iley/nixie-clock/README.md

Yet another nixie clock
=======================

This repo contains hardware design files and firmware source code for a nixie tube clock.

The clock uses soviet IN-12 tubes and K155ID1 driver ICs.

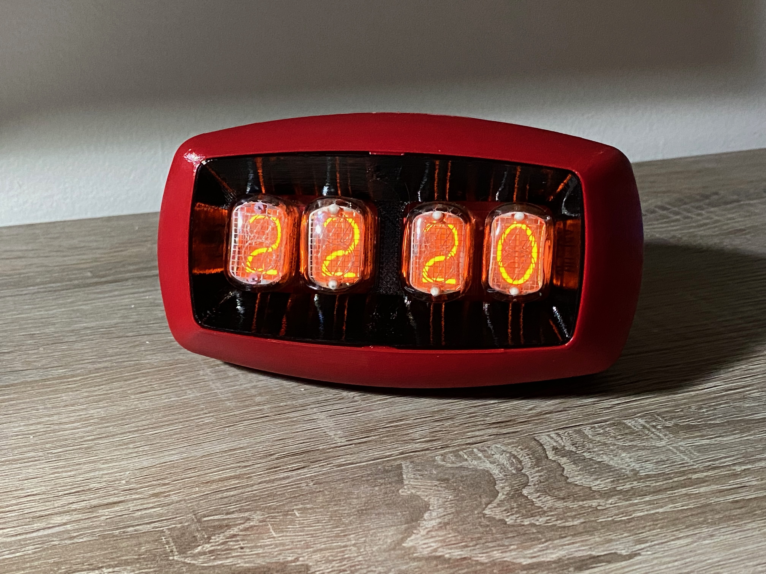
[picture p1: media/nixie_clock_v3.jpeg]
photo of the clock
