iley/nixie-clock/media/nixie_clock_01.jpg

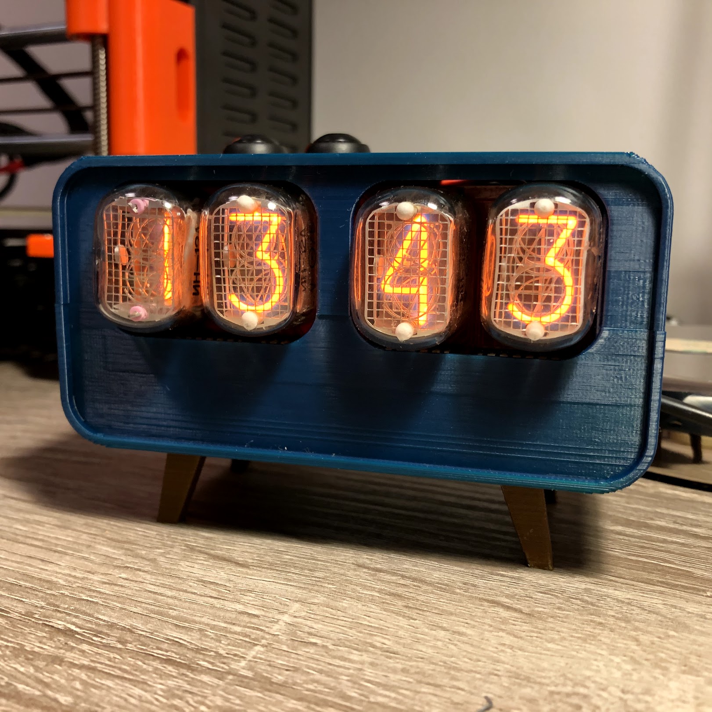
media/nixie_clock_01.jpg
