iley/nixie-clock/pcb/front/nixie_clock_front.step

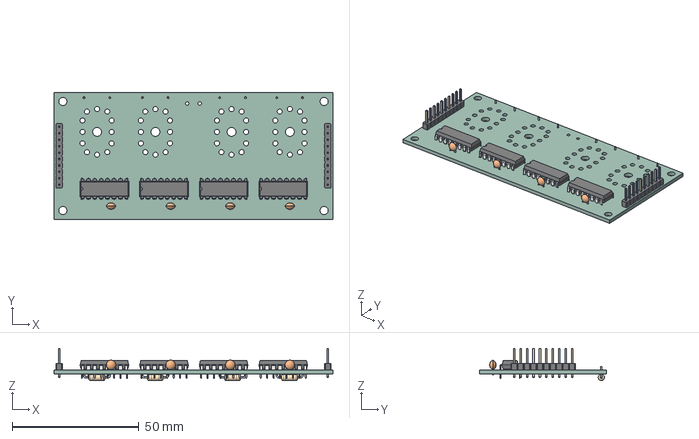
[picture p3: CAD file, 2023-06-15]
pcb/front/nixie_clock_front.step
110.0 x 50.0 x 12.7 mm
_autosave-nixie_clock_front PCB
