iley/nixie-clock/shell/v3/insert.stl

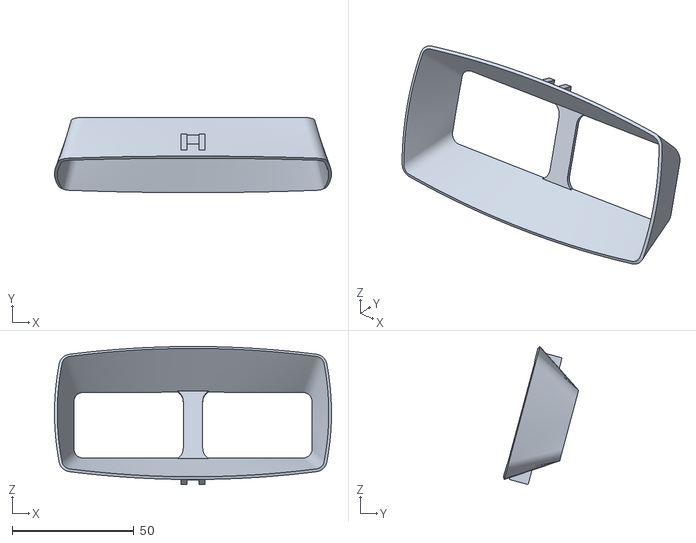
[picture p4: CAD file, 2023-06-15]
shell/v3/insert.stl
113.7 x 30.9 x 56.7
