iley/nixie-clock/shell/v3/front.stl

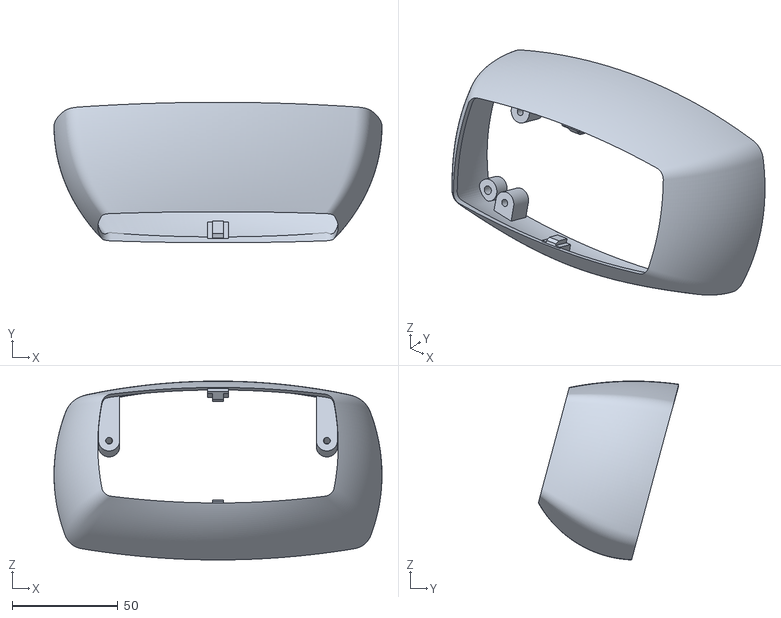
[picture p5: CAD file, 2023-06-15]
shell/v3/front.stl
155.1 x 66.4 x 84.6
