iley/nixie-clock/shell/v3/back.stl

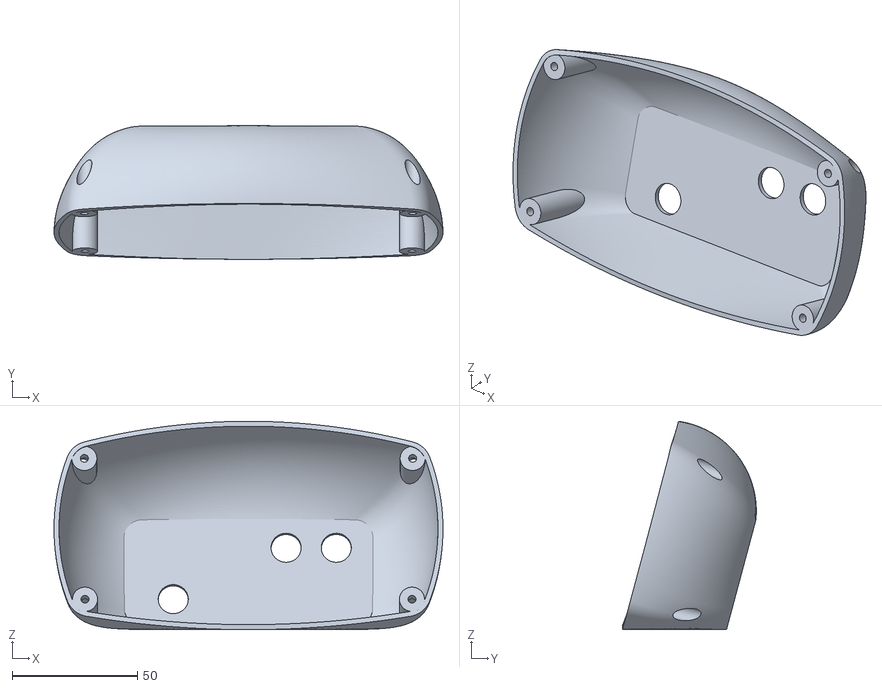
[picture p6: CAD file, 2023-06-15]
shell/v3/back.stl
155.1 x 53.3 x 83.1
