iley/nixie-clock/shell/v1/nixie_clock_case_upper.stl

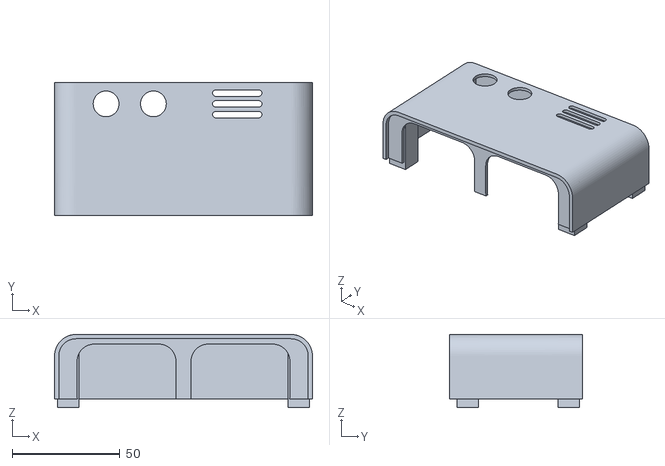
[picture p7: CAD file, 2019-11-12, an earlier design]
shell/v1/nixie_clock_case_upper.stl
120.0 x 62.0 x 34.0
