iley/nixie-clock/shell/v2/stand.stl

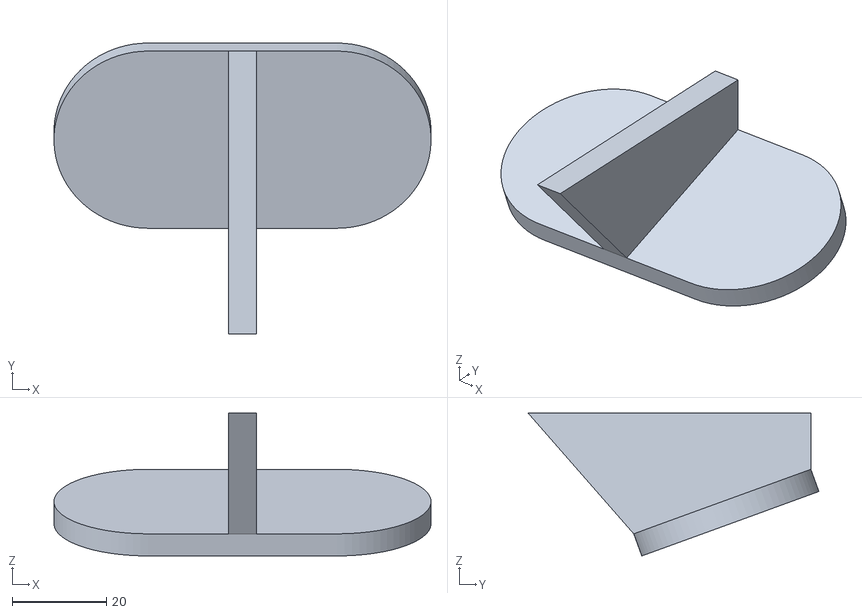
[picture p8: CAD file, 2020-01-18, an earlier design]
shell/v2/stand.stl
80.0 x 61.7 x 30.3
