iley/nixie-clock/shell/v1/nixie_clock_case_lower.stl

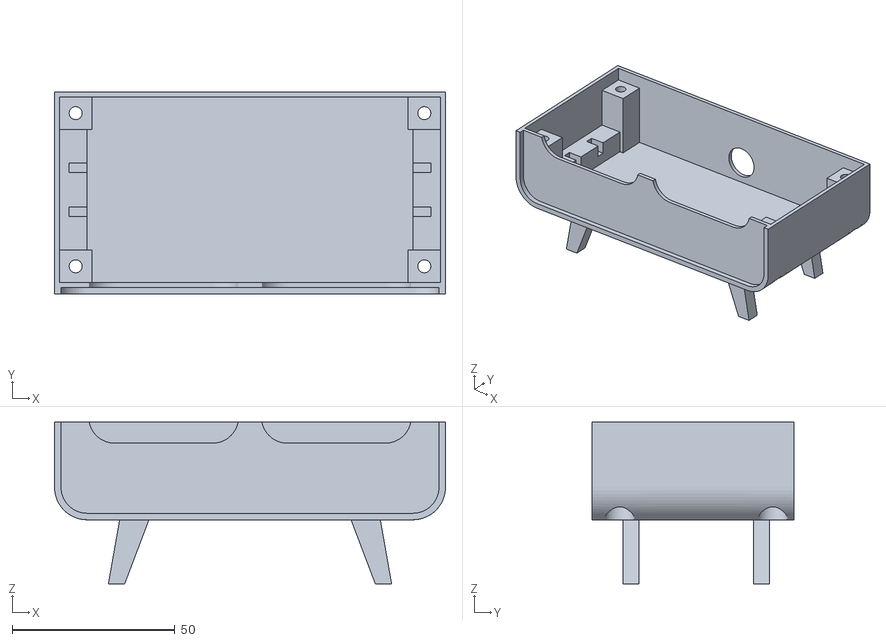
[picture p9: CAD file, 2019-11-12, an earlier design]
shell/v1/nixie_clock_case_lower.stl
120.0 x 62.0 x 49.7
