iley/nixie-clock/shell/v2/lower.stl

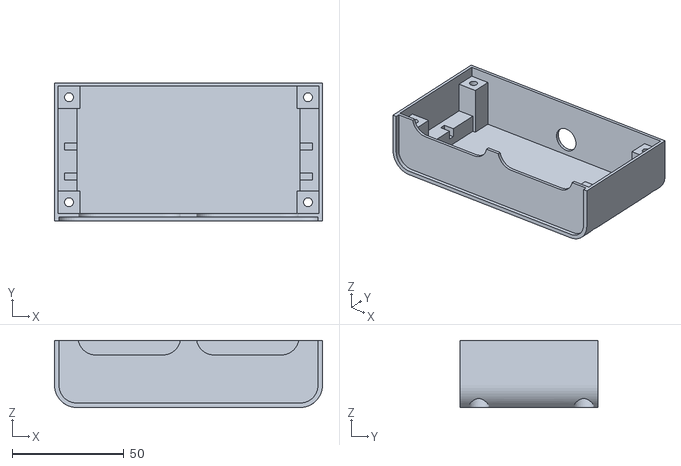
[picture p10: CAD file, 2020-01-18, an earlier design]
shell/v2/lower.stl
120.0 x 62.0 x 30.0
