iley/nixie-clock/(list of files, cad)

Other CAD files:
shell/v2/upper.stl
shell/v1/nixie_clock_case.f3d
shell/v2/shell_v2.f3d
