iley/nixie-clock/pcb/back/schematic.pdf

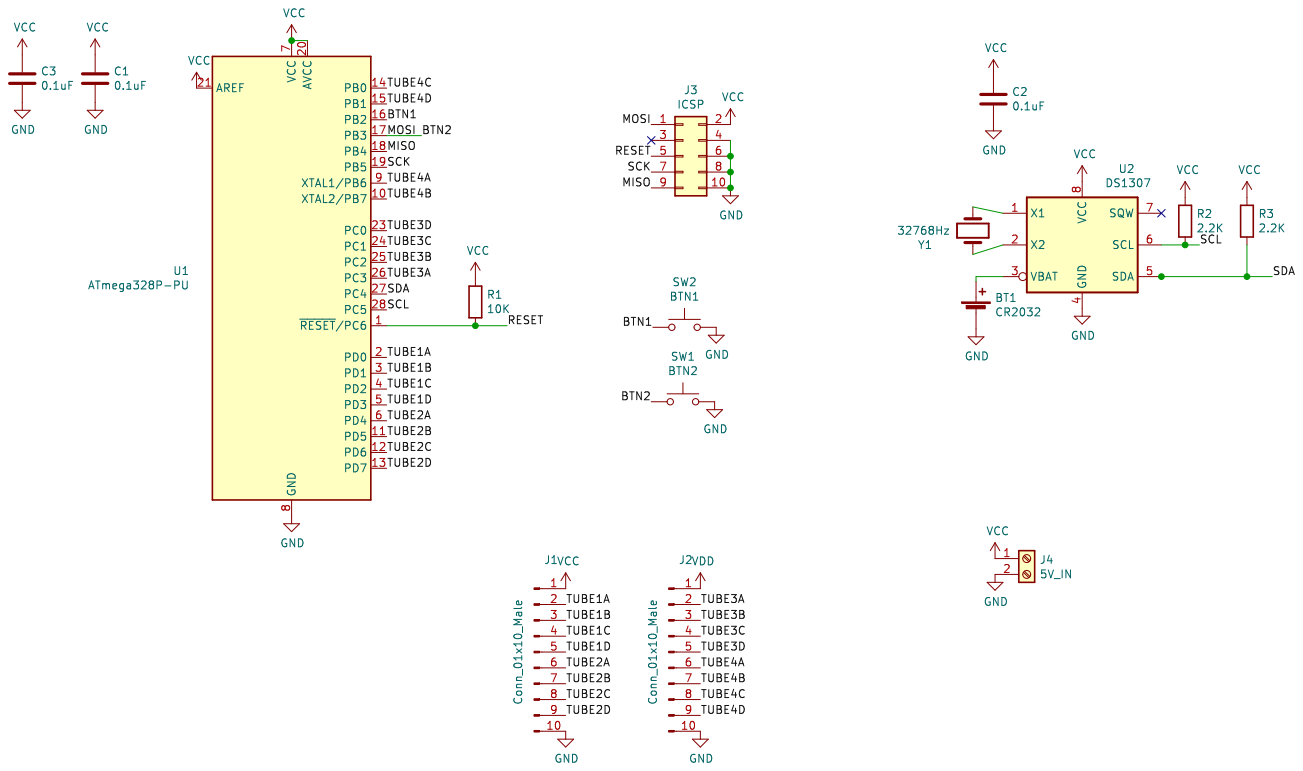
[picture p11: page 1]
