iley/nixie-clock/pcb/back_v3/nixie_back_v3.kicad_pcb

## KiCad design pcb/back_v3/nixie_back_v3.kicad_pcb (2023-06-10)

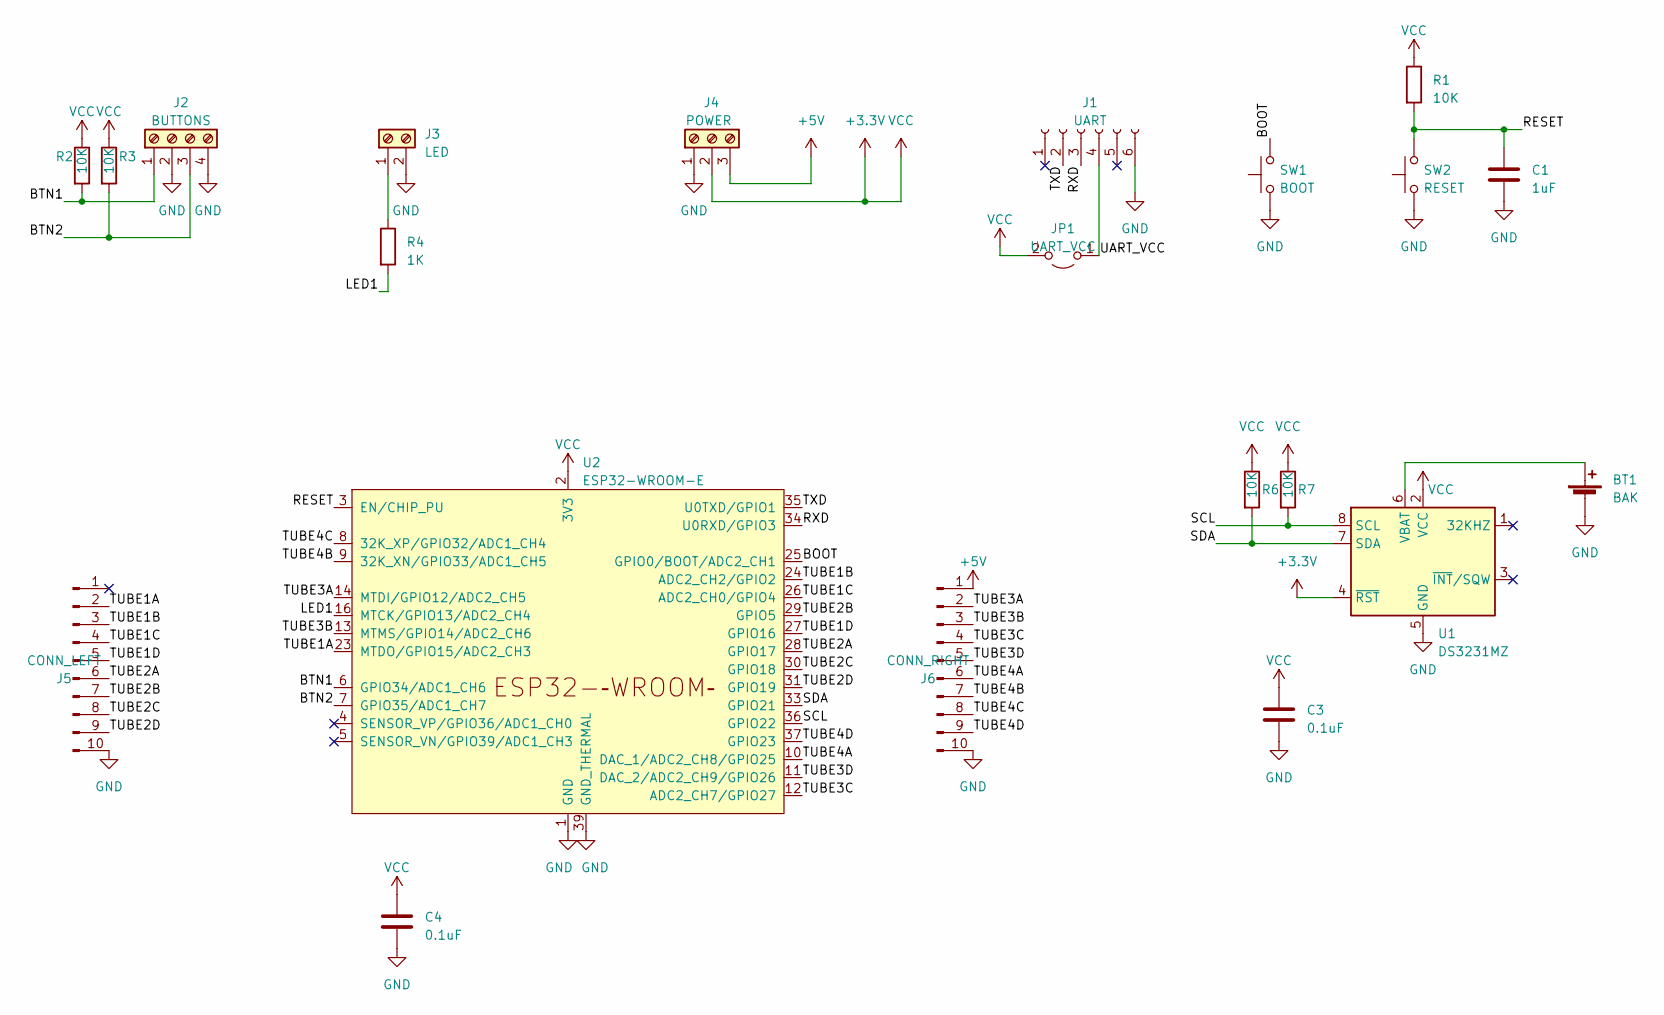
[picture p12: schematic nixie_back_v3.kicad_sch, Nixie Clock Back Panel]

Parts:
BT1: BAK; BatteryHolder_Keystone_103_1x20mm
C1: 1uF; C_1206_3216Metric_Pad1.33x1.80mm_HandSolder
C3, C4: 0.1uF; C_1206_3216Metric_Pad1.33x1.80mm_HandSolder
J1: UART; PinHeader_1x06_P2.54mm_Vertical
J2: BUTTONS; TerminalBlock_Altech_AK300-4_P5.00mm
J3: LED; TerminalBlock_Altech_AK300-2_P5.00mm
J4: POWER; TerminalBlock_Altech_AK300-3_P5.00mm
J5: CONN_LEFT; PinSocket_1x10_P2.54mm_Vertical
J6: CONN_RIGHT; PinSocket_1x10_P2.54mm_Vertical
JP1: UART_VCC; PinHeader_1x02_P2.54mm_Vertical
R1, R2, R3, R6, R7: 10K; R_1206_3216Metric_Pad1.30x1.75mm_HandSolder
R4: 1K; R_1206_3216Metric_Pad1.30x1.75mm_HandSolder
SW1: BOOT; SW_Push_1P1T_XKB_TS-1187A
SW2: RESET; SW_Push_1P1T_XKB_TS-1187A
U1: DS3231MZ; SOIC-8_3.9x4.9mm_P1.27mm
U2: ESP32-WROOM-E; ESP32-WROOM-32E

Connections:
+3.3V: C3.1, C4.1, J4.2, JP1.2 (B), R1.1, R2.1, R3.1, R6.1, R7.1, U1.2 (VCC), U1.4 (~RST), U2.2 (3V3)
+5V: J4.3, J6.1
/BOOT: SW1.2, U2.25 (GPIO0/BOOT/ADC2_CH1)
/BTN1: J2.1, R2.2, U2.6 (GPIO34/ADC1_CH6)
/BTN2: J2.3, R3.2, U2.7 (GPIO35/ADC1_CH7)
/LED1: R4.2, U2.16 (MTCK/GPIO13/ADC2_CH4)
/RESET: C1.1, R1.2, SW2.2, U2.3 (EN/CHIP_PU)
/RXD: J1.3, U2.34 (U0RXD/GPIO3)
/SCL: R7.2, U1.8 (SCL), U2.36 (GPIO22)
/SDA: R6.2, U1.7 (SDA), U2.33 (GPIO21)
/TUBE1A: J5.2, U2.23 (MTDO/GPIO15/ADC2_CH3)
/TUBE1B: J5.3, U2.24 (ADC2_CH2/GPIO2)
/TUBE1C: J5.4, U2.26 (ADC2_CH0/GPIO4)
/TUBE1D: J5.5, U2.27 (GPIO16)
/TUBE2A: J5.6, U2.28 (GPIO17)
/TUBE2B: J5.7, U2.29 (GPIO5)
/TUBE2C: J5.8, U2.30 (GPIO18)
/TUBE2D: J5.9, U2.31 (GPIO19)
/TUBE3A: J6.2, U2.14 (MTDI/GPIO12/ADC2_CH5)
/TUBE3B: J6.3, U2.13 (MTMS/GPIO14/ADC2_CH6)
/TUBE3C: J6.4, U2.12 (ADC2_CH7/GPIO27)
/TUBE3D: J6.5, U2.11 (DAC_2/ADC2_CH9/GPIO26)
/TUBE4A: J6.6, U2.10 (DAC_1/ADC2_CH8/GPIO25)
/TUBE4B: J6.7, U2.9 (32K_XN/GPIO33/ADC1_CH5)
/TUBE4C: J6.8, U2.8 (32K_XP/GPIO32/ADC1_CH4)
/TUBE4D: J6.9, U2.37 (GPIO23)
/TXD: J1.2, U2.35 (U0TXD/GPIO1)
/UART_VCC: J1.4, JP1.1 (A)
GND: BT1.2 (-), C1.2, C3.2, C4.2, J1.6, J2.2, J2.4, J3.2, J4.1, J5.10, J6.10, SW1.1, SW2.1, U1.5 (GND), U2.1 (GND), U2.15 (GND), U2.38 (GND), U2.39 (GND_THERMAL)
unnamed: BT1.1 (+), U1.6 (VBAT)
unnamed: J3.1, R4.1

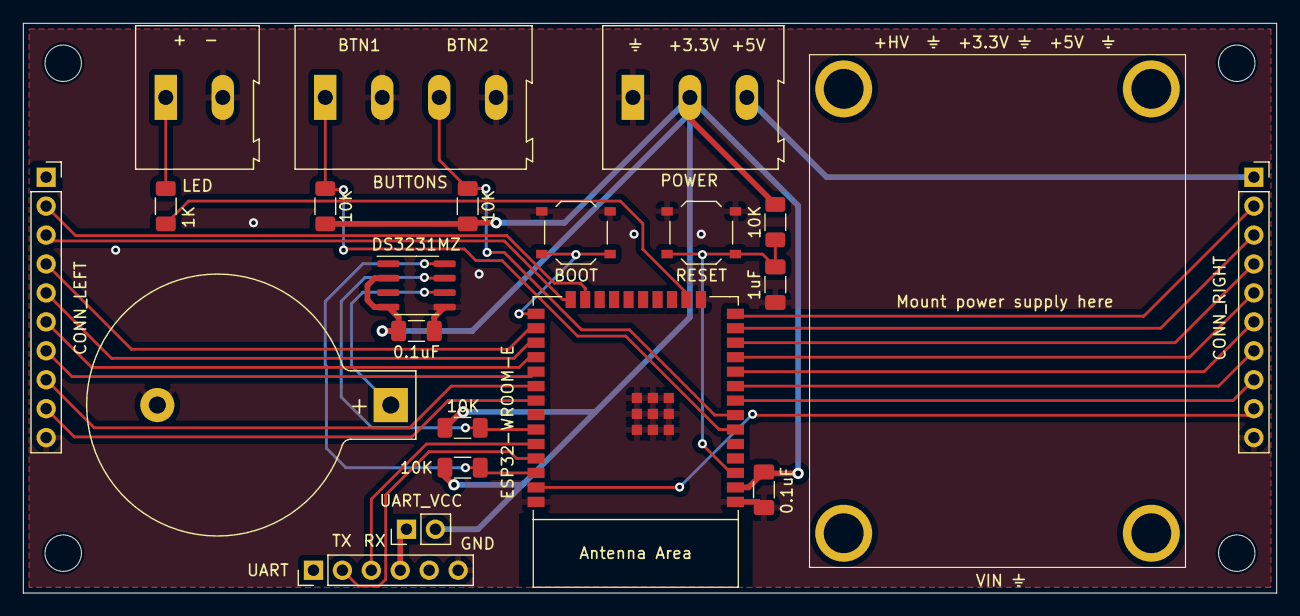
[picture p13: board nixie_back_v3.kicad_pcb from above]

Board: 2 copper layers, 110.0 x 50.0 mm, 21 parts (0 on the bottom side), 31 nets.
