iley/nixie-clock/pcb/back/nixie_clock_back.kicad_pcb

## KiCad design pcb/back/nixie_clock_back.kicad_pcb (2023-02-11, an earlier design)

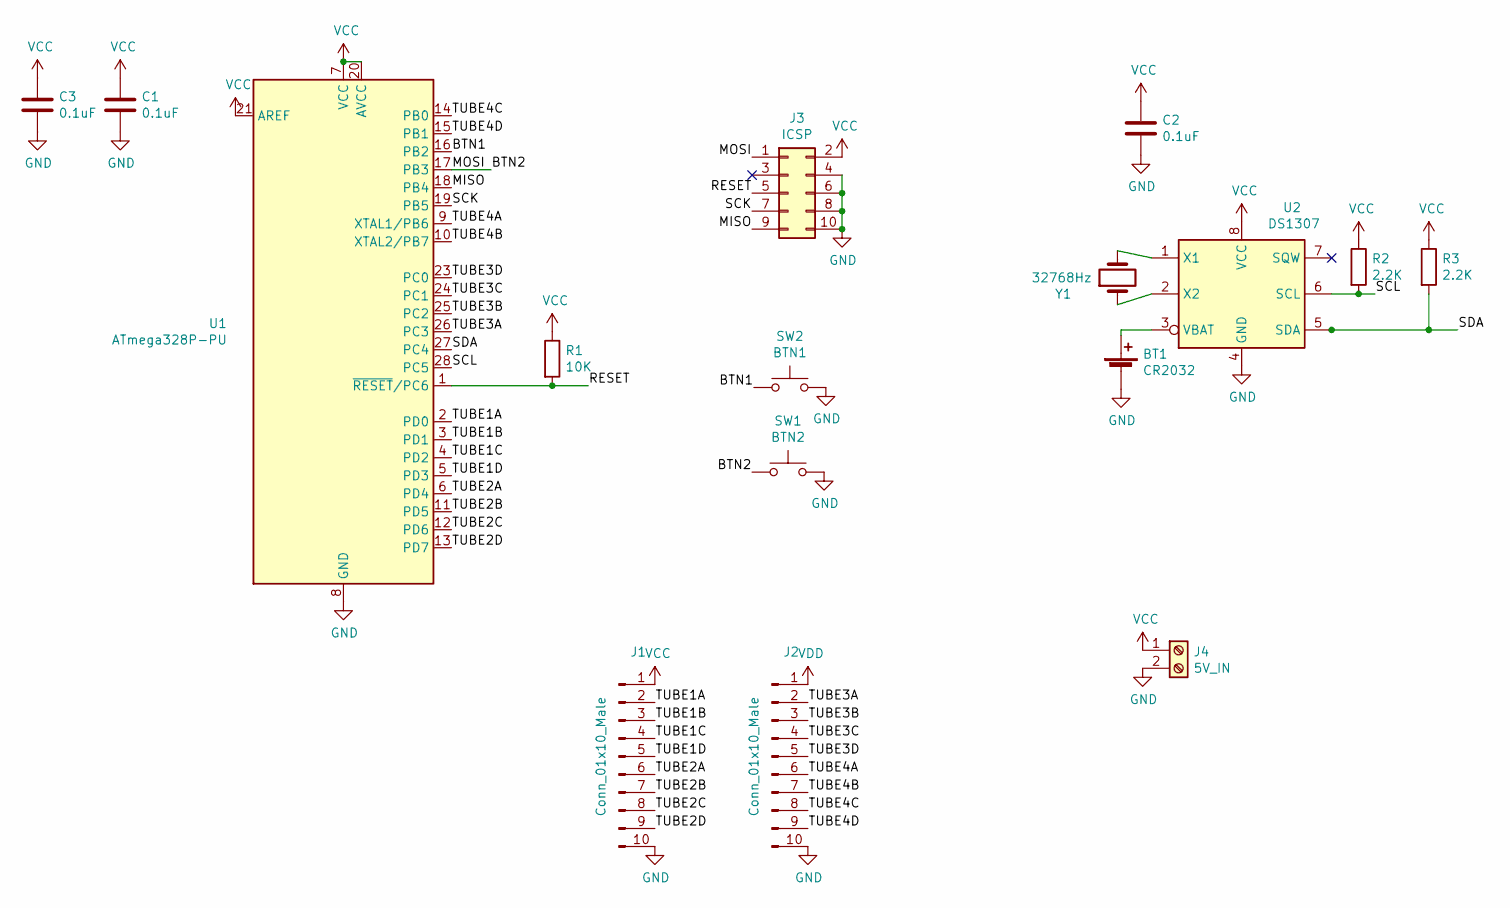
[picture p14: schematic nixie_clock_back.kicad_sch]

Parts:
BT1: CR2032; BatteryHolder_Keystone_103_1x20mm
C1, C2, C3: 0.1uF; C_Disc_D3.8mm_W2.6mm_P2.50mm
J1, J2: Conn_01x10_Male; PinSocket_1x10_P2.54mm_Vertical
J3: ICSP; Atmel_ISP_Socket_10pin
J4: 5V_IN; Terminal_Block_KF301-5.0-2P
R1: 10K; R_Axial_DIN0207_L6.3mm_D2.5mm_P10.16mm_Horizontal
R2, R3: 2.2K; R_Axial_DIN0207_L6.3mm_D2.5mm_P10.16mm_Horizontal
SW1: BTN2; JST_XH_B2B-XH-A_1x02_P2.50mm_Vertical
SW2: BTN1; JST_XH_B2B-XH-A_1x02_P2.50mm_Vertical
U1: ATmega328P-PU; DIP-28_W7.62mm
U2: DS1307; DIP-8_W7.62mm
Y1: 32768Hz; Crystal_C38-LF_D3.0mm_L8.0mm_Horizontal

Connections:
/BTN1: SW2.1, U1.16 (PB2)
/BTN2: J3.1, SW1.1, U1.17 (PB3)
/MISO: J3.9, U1.18 (PB4)
/RESET: J3.5, R1.2, U1.1 (~RESET/PC6)
/SCK: J3.7, U1.19 (PB5)
/SCL: R2.2, U1.28 (PC5), U2.6 (SCL)
/SDA: R3.2, U1.27 (PC4), U2.5 (SDA)
/TUBE1A: J1.2, U1.2 (PD0)
/TUBE1B: J1.3, U1.3 (PD1)
/TUBE1C: J1.4, U1.4 (PD2)
/TUBE1D: J1.5, U1.5 (PD3)
/TUBE2A: J1.6, U1.6 (PD4)
/TUBE2B: J1.7, U1.11 (PD5)
/TUBE2C: J1.8, U1.12 (PD6)
/TUBE2D: J1.9, U1.13 (PD7)
/TUBE3A: J2.2, U1.26 (PC3)
/TUBE3B: J2.3, U1.25 (PC2)
/TUBE3C: J2.4, U1.24 (PC1)
/TUBE3D: J2.5, U1.23 (PC0)
/TUBE4A: J2.6, U1.9 (XTAL1/PB6)
/TUBE4B: J2.7, U1.10 (XTAL2/PB7)
/TUBE4C: J2.8, U1.14 (PB0)
/TUBE4D: J2.9, U1.15 (PB1)
GND: BT1.2 (-), C1.2, C2.2, C3.2, J1.10, J2.10, J3.4, J3.6, J3.8, J3.10, J4.2, SW1.2, SW2.2, U1.8 (GND), U1.22 (GND), U2.4 (GND)
unnamed: BT1.1 (+), U2.3 (VBAT)
unnamed: U2.1 (X1), Y1.2
unnamed: U2.2 (X2), Y1.1
VCC: C1.1, C2.1, C3.1, J1.1, J3.2, J4.1, R1.1, R2.1, R3.1, U1.7 (VCC), U1.20 (AVCC), U1.21 (AREF), U2.8 (VCC)
VDD: J2.1

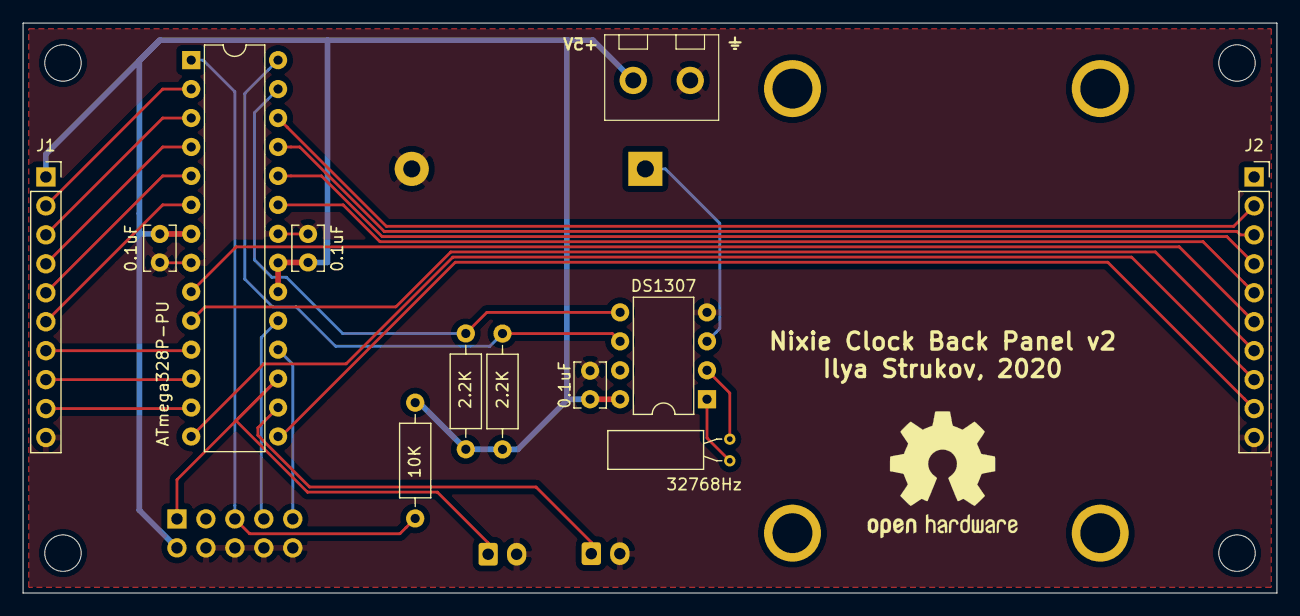
[picture p15: board nixie_clock_back.kicad_pcb from above]

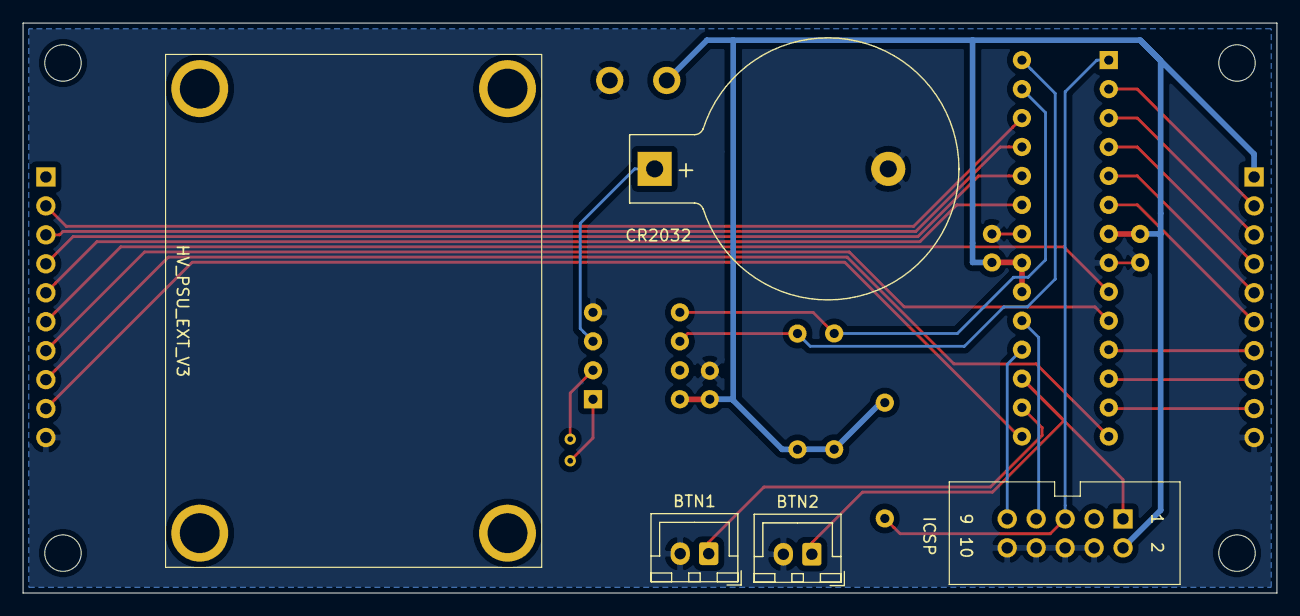
[picture p16: board nixie_clock_back.kicad_pcb from below]

Board: 2 copper layers, 110.0 x 50.0 mm, 16 parts (4 on the bottom side), 28 nets.
