iley/nixie-clock/pcb/front/nixie_clock_front.kicad_pcb

## KiCad design pcb/front/nixie_clock_front.kicad_pcb (2019-11-10)

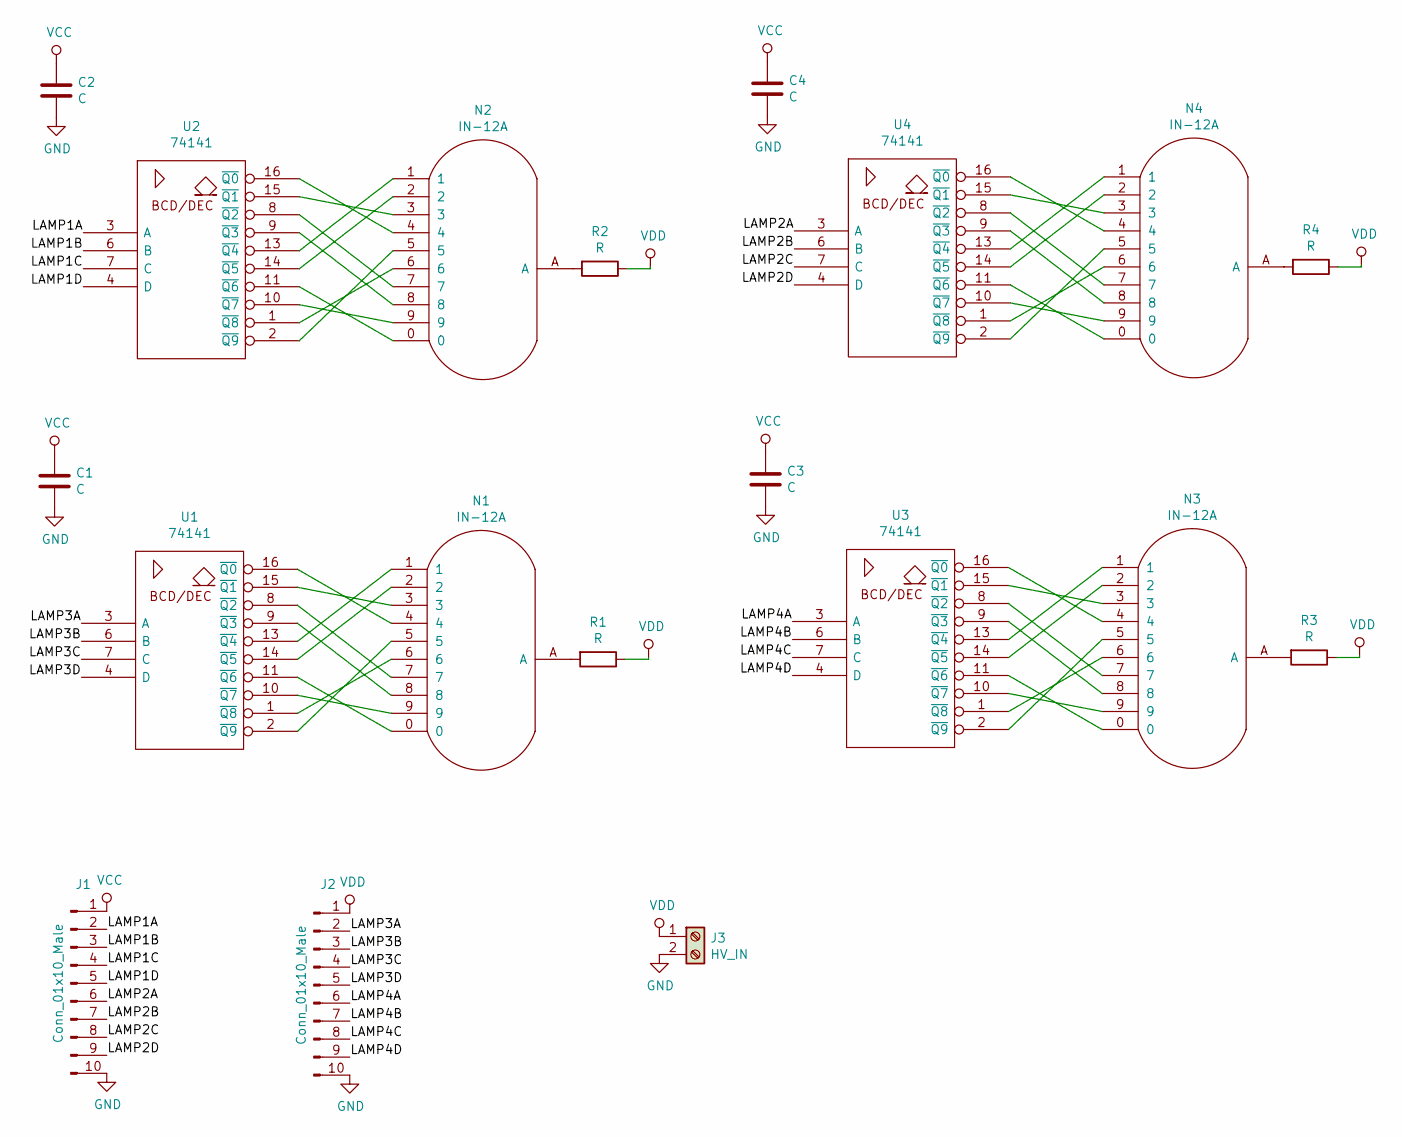
[picture p17: schematic nixie_clock_front.sch]

Parts:
C1, C2, C3, C4: C; C_Disc_D3.8mm_W2.6mm_P2.50mm
J1, J2: Conn_01x10_Male; PinHeader_1x10_P2.54mm_Vertical
J3: HV_IN; Terminal_Block_KF301-5.0-2P
N1, N2, N3, N4: IN-12A
R1, R2, R3, R4: R; R_Axial_DIN0207_L6.3mm_D2.5mm_P10.16mm_Horizontal
U1, U2, U3, U4: 74141; DIP-16_W7.62mm

Connections:
/LAMP1A: J1.2, U2.3 (A)
/LAMP1B: J1.3, U2.6 (B)
/LAMP1C: J1.4, U2.7 (C)
/LAMP1D: J1.5, U2.4 (D)
/LAMP2A: J1.6, U4.3 (A)
/LAMP2B: J1.7, U4.6 (B)
/LAMP2C: J1.8, U4.7 (C)
/LAMP2D: J1.9, U4.4 (D)
/LAMP3A: J2.2, U1.3 (A)
/LAMP3B: J2.3, U1.6 (B)
/LAMP3C: J2.4, U1.7 (C)
/LAMP3D: J2.5, U1.4 (D)
/LAMP4A: J2.6, U3.3 (A)
/LAMP4B: J2.7, U3.6 (B)
/LAMP4C: J2.8, U3.7 (C)
/LAMP4D: J2.9, U3.4 (D)
GND: C1.2, C2.2, C3.2, C4.2, J1.10, J2.10, J3.2, U1.12 (GND), U2.12 (GND), U3.12 (GND), U4.12 (GND)
unnamed: N1.0, U1.11 (~Q6)
unnamed: N1.1, U1.13 (~Q4)
unnamed: N1.2, U1.14 (~Q5)
unnamed: N1.3, U1.15 (~Q1)
unnamed: N1.4, U1.16 (~Q0)
unnamed: N1.5, U1.2 (~Q9)
unnamed: N1.6, U1.1 (~Q8)
unnamed: N1.7, U1.8 (~Q2)
unnamed: N1.8, U1.9 (~Q3)
unnamed: N1.9, U1.10 (~Q7)
unnamed: N1.A, R1.2
unnamed: N2.0, U2.11 (~Q6)
unnamed: N2.1, U2.13 (~Q4)
unnamed: N2.2, U2.14 (~Q5)
unnamed: N2.3, U2.15 (~Q1)
unnamed: N2.4, U2.16 (~Q0)
unnamed: N2.5, U2.2 (~Q9)
unnamed: N2.6, U2.1 (~Q8)
unnamed: N2.7, U2.8 (~Q2)
unnamed: N2.8, U2.9 (~Q3)
unnamed: N2.9, U2.10 (~Q7)
unnamed: N2.A, R2.2
unnamed: N3.0, U3.11 (~Q6)
unnamed: N3.1, U3.13 (~Q4)
unnamed: N3.2, U3.14 (~Q5)
unnamed: N3.3, U3.15 (~Q1)
unnamed: N3.4, U3.16 (~Q0)
unnamed: N3.5, U3.2 (~Q9)
unnamed: N3.6, U3.1 (~Q8)
unnamed: N3.7, U3.8 (~Q2)
unnamed: N3.8, U3.9 (~Q3)
unnamed: N3.9, U3.10 (~Q7)
unnamed: N3.A, R3.2
unnamed: N4.0, U4.11 (~Q6)
unnamed: N4.1, U4.13 (~Q4)
unnamed: N4.2, U4.14 (~Q5)
unnamed: N4.3, U4.15 (~Q1)
unnamed: N4.4, U4.16 (~Q0)
unnamed: N4.5, U4.2 (~Q9)
unnamed: N4.6, U4.1 (~Q8)
unnamed: N4.7, U4.8 (~Q2)
unnamed: N4.8, U4.9 (~Q3)
unnamed: N4.9, U4.10 (~Q7)
unnamed: N4.A, R4.2
VCC: C1.1, C2.1, C3.1, C4.1, J1.1, U1.5 (VCC), U2.5 (VCC), U3.5 (VCC), U4.5 (VCC)
VDD: J2.1, J3.1, R1.1, R2.1, R3.1, R4.1

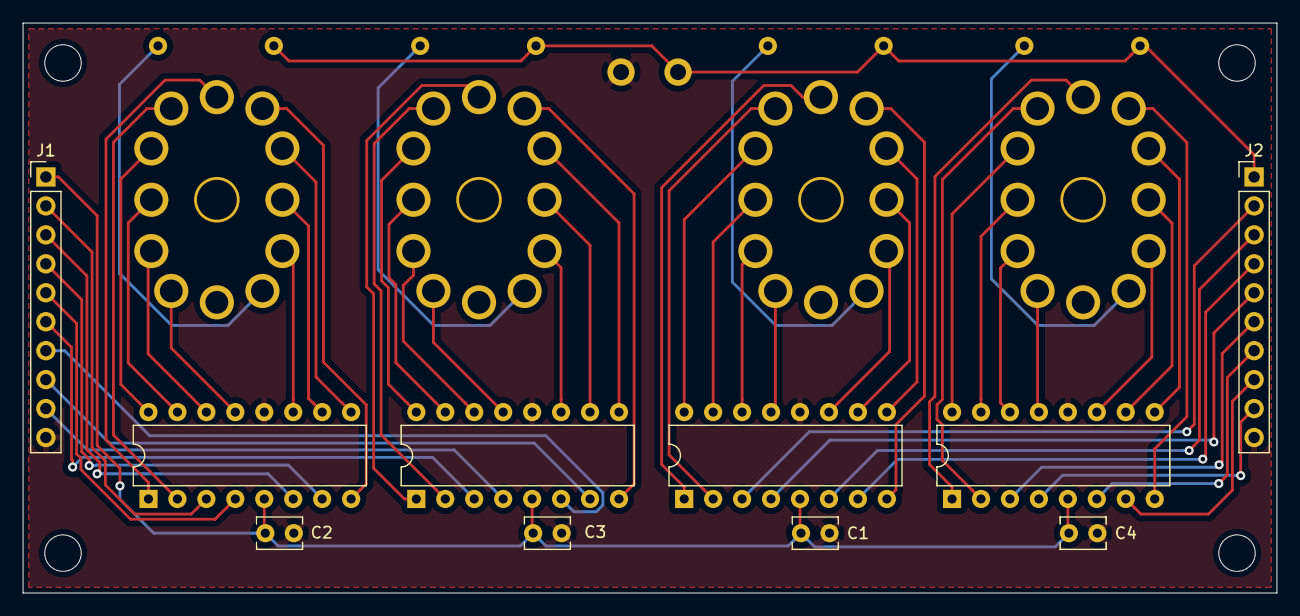
[picture p18: board nixie_clock_front.kicad_pcb from above]

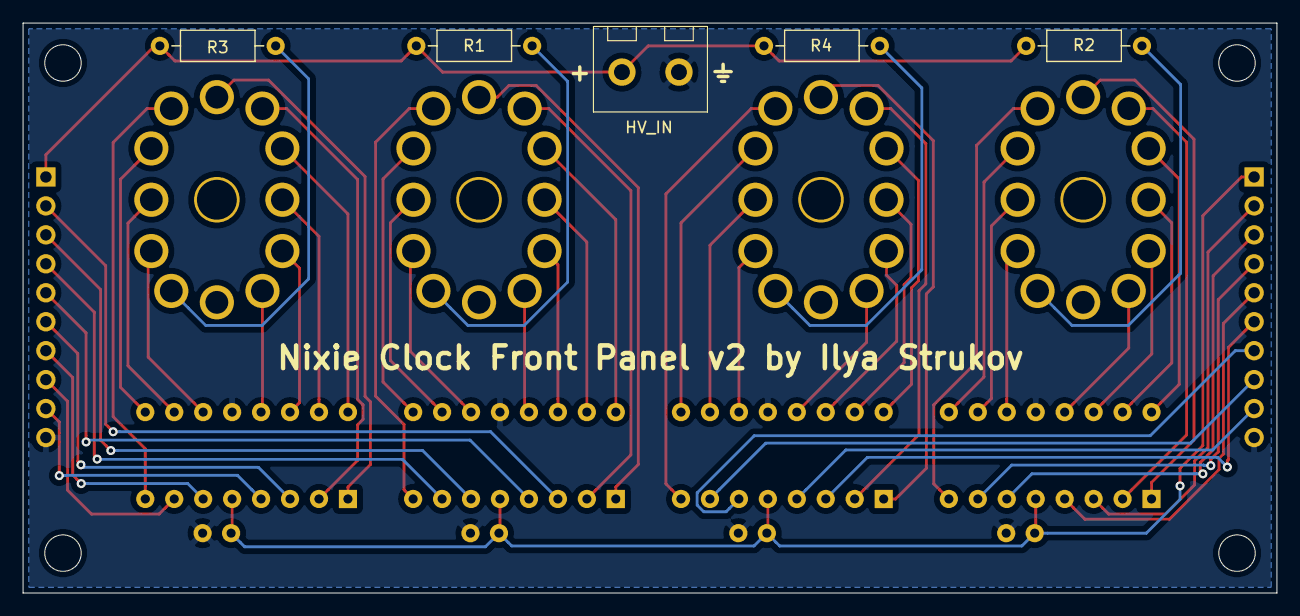
[picture p19: board nixie_clock_front.kicad_pcb from below]

Board: 2 copper layers, 110.0 x 50.0 mm, 19 parts (5 on the bottom side), 63 nets.
