iley/nixie-clock/firmware_esp32/include/sync.h

#ifndef _NIXIE_CLOCK_SYNC_H
#define _NIXIE_CLOCK_SYNC_H

#include "rtc.h"

bool fetchCurrentTimeFromNtp(struct tm* datetime);
void utcToLocal(const struct tm* utc, struct tm* local);
void localToUtc(const struct tm* local, struct tm* utc);

#endif // _NIXIE_CLOCK_SYNC_H
