iley/nixie-clock/(commit log)

2019-10-19 Front PCB schematic
    [nixie_clock_front.kicad_pcb, nixie_clock_front.sch]
2019-10-19 Front panel PCB layout
    [nixie_clock_front.kicad_pcb]
2019-10-19 Generate gerbers
    [nixie_clock_front.kicad_pcb]
2019-10-19 Start the back PCB
    [nixie_clock_back.kicad_pcb, nixie_clock_back.sch]
2019-10-20 Back panel PCB
    [nixie_clock_back.kicad_pcb, nixie_clock_back.sch, nixie_clock_front.kicad_pcb, nixie_clock_front.sch]
2019-11-09 Final PCB tweaks
    [nixie_clock_back.kicad_pcb]
2019-11-10 Add case Fusion 360 model
    [nixie_clock_case.f3d]
2019-11-10 Random PCB changes
    [nixie_clock_front.kicad_pcb]
2019-11-12 Improve the case
    [nixie_clock_case.f3d, nixie_clock_case_lower.stl, nixie_clock_case_upper.stl]
2019-11-16 Track time since boot using timer interrupts
2019-11-16 Handle buttons
2019-11-16 Add missing PCB trace
    [nixie_clock_back.kicad_pcb]
2019-12-16 Fix a bug in time setting routine
    [main.c]
2020-01-18 Fix minor issues on the back PCB
    [nixie_clock_back.kicad_pcb]
2020-01-18 Add shell v2
    [lower.stl, nixie_clock_case.f3d, nixie_clock_case_lower.stl, nixie_clock_case_upper.stl, shell_v2.f3d, stand.stl, upper.stl]
2020-02-15 Code formatting and a missing #include
    [i2c.c, rtc.h]
2021-04-24 Replace PlatformIO with make+docker
    [i2c.c, i2c.h, main.c, rtc.c, rtc.h]
2022-11-16 Update back PCB schematic
    [nixie_clock_back.kicad_sch]
2022-11-26 Pico SDK setup
2022-11-26 Pico PIO test
2022-11-27 Enable trickle charging
2023-02-11 back pcb: upgrade to kicad 6, add measurements
    [nixie_clock_back.kicad_pcb]
2023-02-11 Random changes in the v2 firmware prototype
2023-02-11 Start v2 back pcb
    [nixie_back_v2.kicad_pcb, nixie_back_v2.kicad_sch]
2023-04-23 Schematic for back PCB v2
    [nixie_back_v2.kicad_sch]
2023-04-30 Lay out the new back panel pcb
    [nixie_back_v2.kicad_pcb, nixie_back_v2.kicad_sch]
2023-04-30 Rename kicad project
    [nixie_back_v3.kicad_pcb, nixie_back_v3.kicad_sch]
2023-04-30 Add gerbers directory
2023-05-28 Update front PCB to newer KiCAD version
2023-05-28 Fix pin assignment on v3 back pcb
    GPIO pins 34-39 on ESP32 are input only.
    [nixie_back_v3.kicad_pcb, nixie_back_v3.kicad_sch]
2023-05-28 Dummy ESP32 firmware
2023-06-10 Misc PCB changes
    [nixie_back_v3.kicad_pcb]
2023-06-10 Update pin numbers
2023-06-15 Add design files for v3
    [back.stl, front.stl, insert.stl, nixie_clock_front.step]
2026-03-08 Fix DST switch
2026-03-09 Update readme for the esp32 firmware
2026-03-09 Add manual sync button
